marcinsaj/Nixie-Clock-Thermometer-Hygrometer-Arduino-Shield/README.md

# Nixie Clock Thermometer Hygrometer Arduino Shield
----
## [Assembly Instruction can be found here](http://bit.ly/nixieshield-assembly)
----

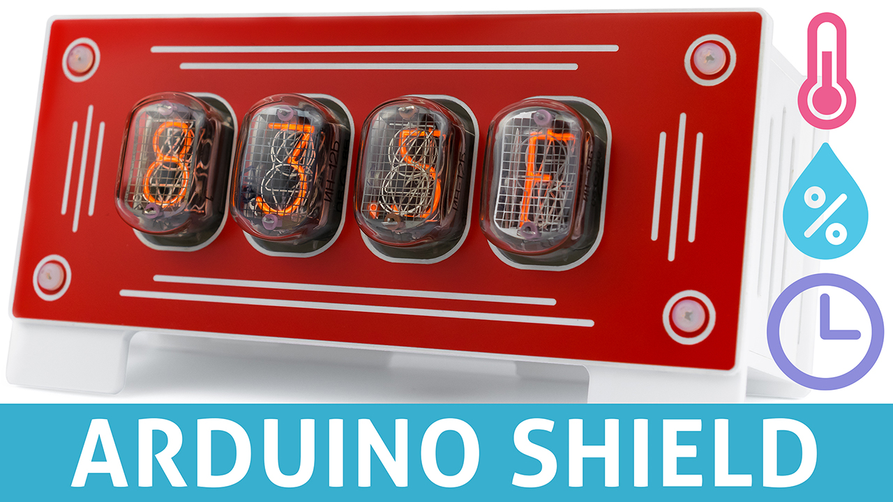
[picture p1: extras/Nixie-Clock-Thermometer-Hygrometer-Arduino-Shield-1.jpg]


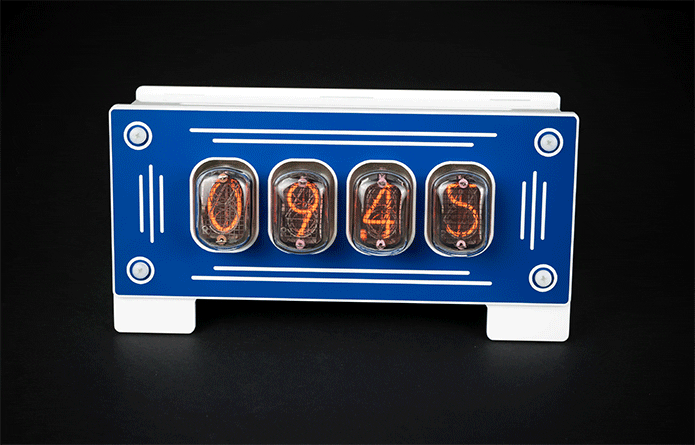
[picture p2: extras/nixie-clock-thermometer-hygrometer-arduino-shield.gif]


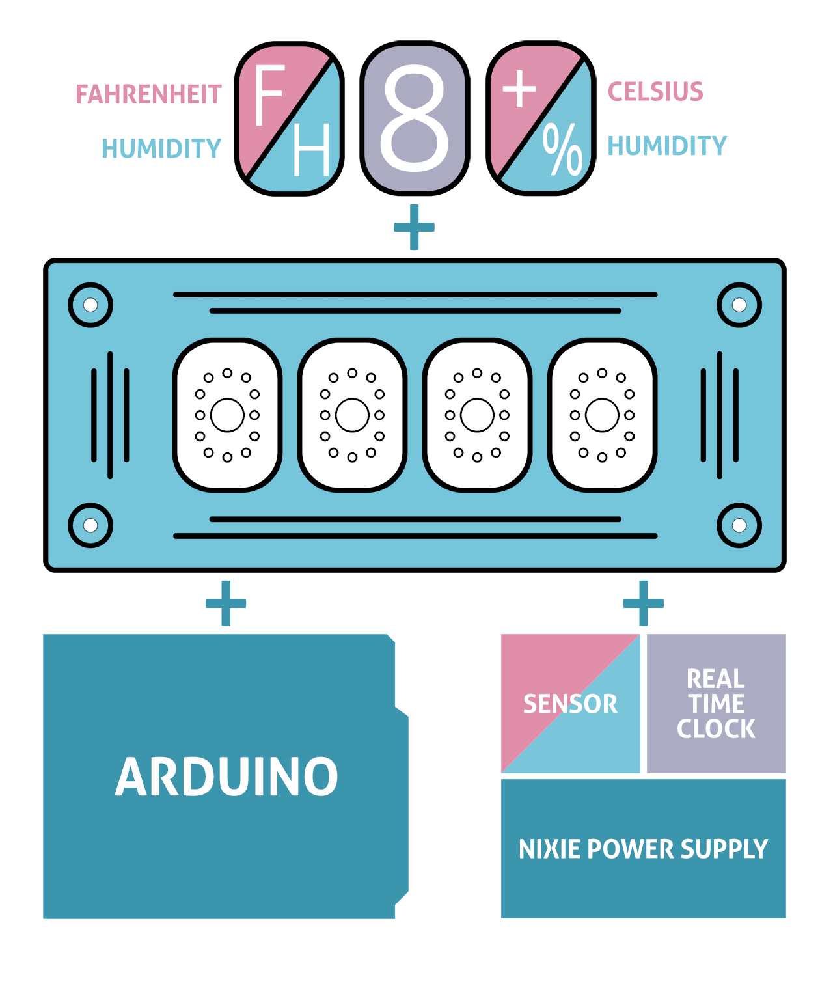
[picture p3: extras/Nixie-Clock-Thermometer-Hygrometer-Arduino-Shield-2.jpg]
