marcinsaj/Nixie-Clock-Thermometer-Hygrometer-Arduino-Shield/assembly-instruction.md

# Assembly Instruction - Nixie Clock Thermometer Hygrometer Arduino Shield
### Components
- Nixie shield mainboard pcb - [schematic](https://github.com/marcinsaj/Nixie-Clock-Thermometer-Hygrometer-Arduino-Shield/blob/master/datasheet/Schematic-Nixie-Clock-Thermometer-Hygrometer-Arduino-Shield.pdf)
- Nixie power supply module (12V => 170V) - [schematic](https://github.com/marcinsaj/Nixie-Clock-Thermometer-Hygrometer-Arduino-Shield/blob/master/datasheet/Schematic-Nixie-Module-Power-Supply.pdf)
- Real time clock module DS3231 - [datasheet](https://github.com/marcinsaj/Nixie-Clock-Thermometer-Hygrometer-Arduino-Shield/blob/master/datasheet/DS3231.pdf)
- Temperature and humidity sensor DHT22/AM2302 - [datasheet](https://github.com/marcinsaj/Nixie-Clock-Thermometer-Hygrometer-Arduino-Shield/blob/master/datasheet/DHT22.pdf)
- Housing
- Other components:
  - Nixie tubes socket pins - 48pcs
  - CON1 (sensor connector)
  - PH1 - pin header 1 x 3F 8.5mm (nixie shield pcb), pin header 1 x 3M 8.5mm (nixie power supply pcb) 
  - PH2 - pin header 1 x 6M 15mm (Arduino)
  - PH3 - pin header 1 x 8M 15mm (Arduino)
  - PH4 - pin header 1 x 4F 8.5mm (nixie shield pcb), pin header 1 x 4M 8.5mm (nixie power supply pcb) 
  - PH5 - pin header 1 x 5M 8.5mm (RTC connector)
  - PH6 - pin header 1 x 8M 15mm (Arduino)
  - PH7 - pin header 1 x 12M 15mm (Arduino)
  - Spacers: 4 x M3-18mm F-F
  - Spacers: 2 x M2.5-18mm M-F
  - Spacers: 2 x M2.5-30mm F-F
  - Spacers: 2 x M2.5-10mm F-F
  - Screws: 8 x M3-8mm
  - Screws: 4 x M2.5-15mm
  - Screws: 4 x M2.5-8mm

----
### Temperature and humidity sensor DHT22/AM2302
----

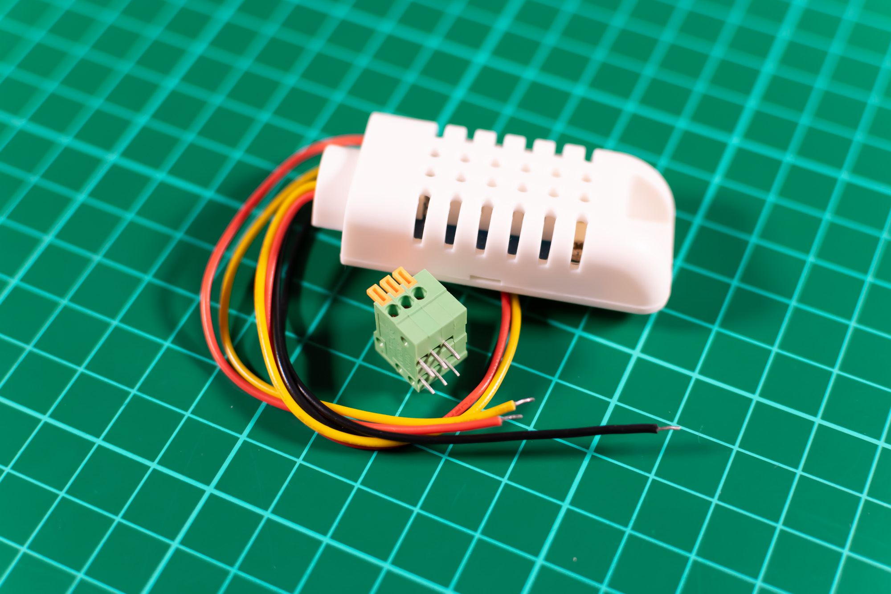
[picture p4: extras/assembly-instruction-images/nixie-shield-assembly-instruction_55.jpg]


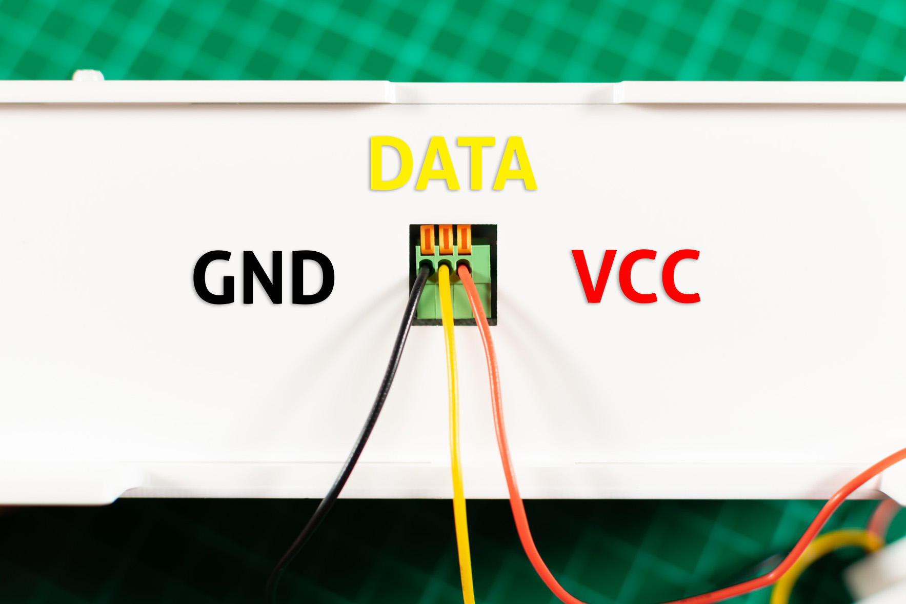
[picture p5: extras/assembly-instruction-images/nixie-shield-assembly-instruction_53.jpg]


----
### Assembly Instruction
----
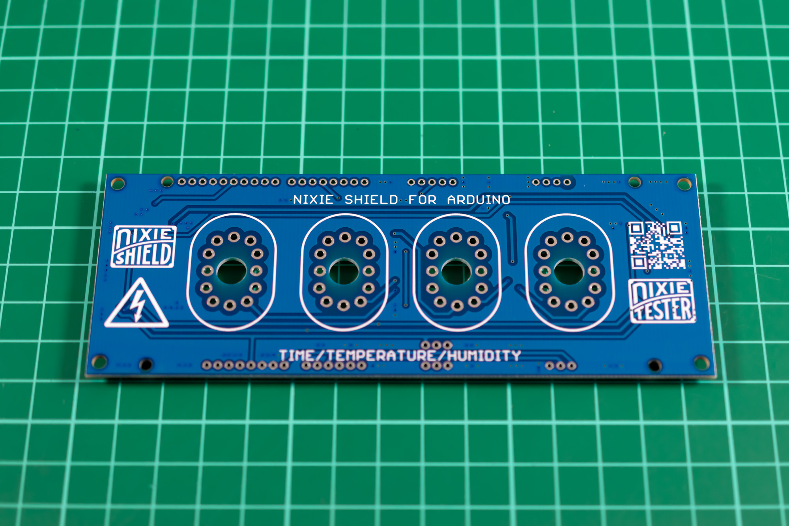
[picture p6: extras/assembly-instruction-images/nixie-shield-assembly-instruction_01.jpg]


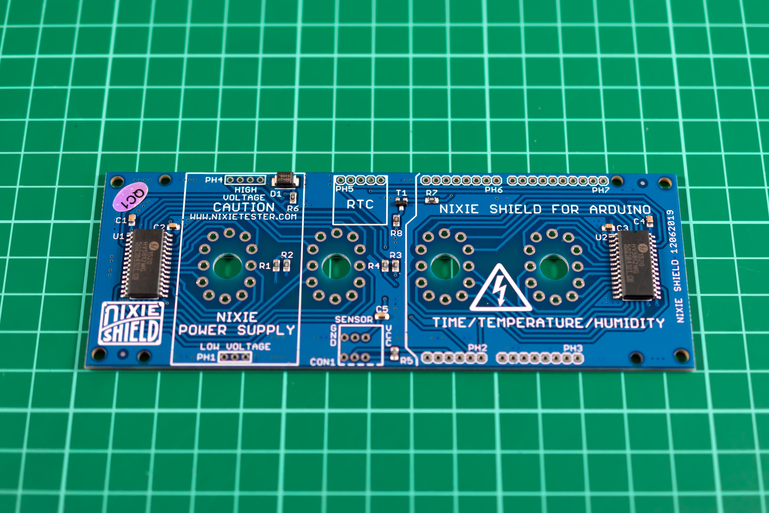
[picture p7: extras/assembly-instruction-images/nixie-shield-assembly-instruction_02.jpg]


----
### PH1 - pin header 1 x 3F 8.5mm

### PH4 - pin header 1 x 4F 8.5mm
----

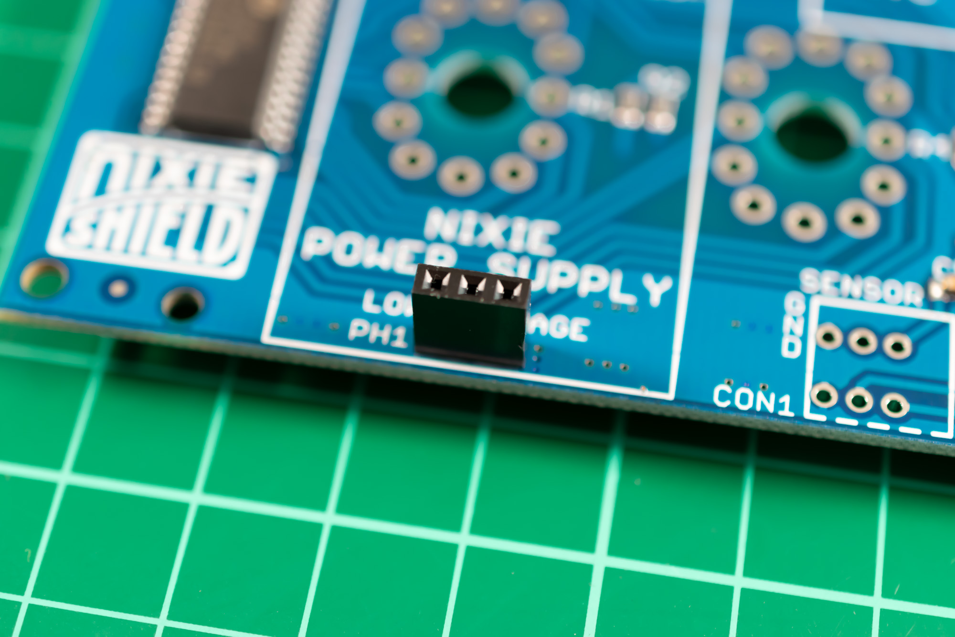
[picture p8: extras/assembly-instruction-images/nixie-shield-assembly-instruction_03.jpg]


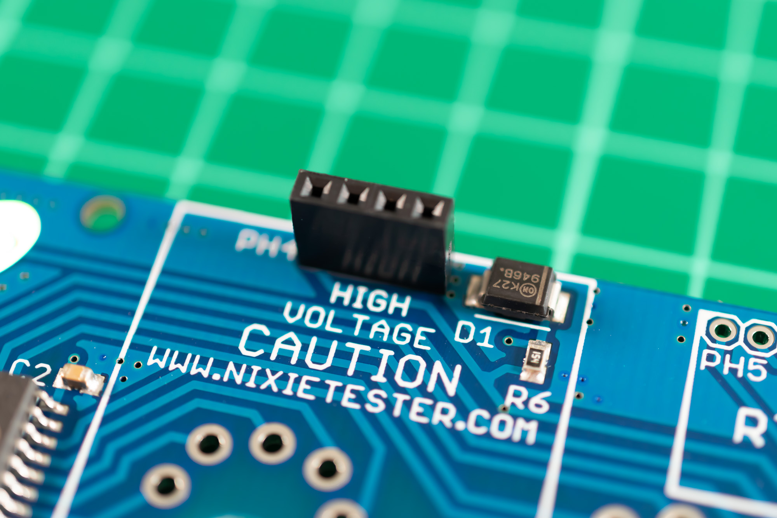
[picture p9: extras/assembly-instruction-images/nixie-shield-assembly-instruction_04.jpg]


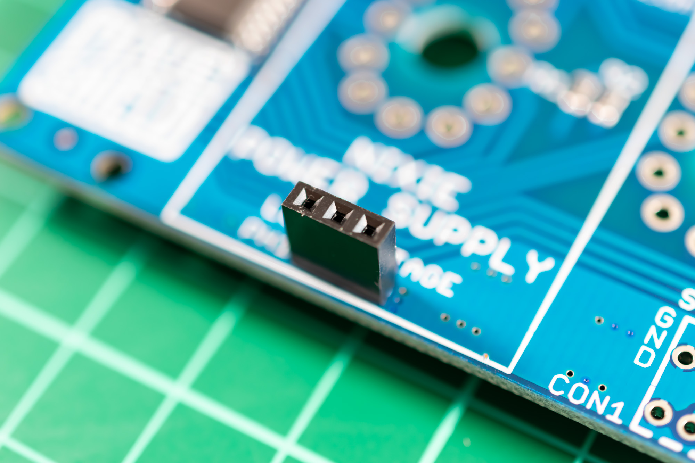
[picture p10: extras/assembly-instruction-images/nixie-shield-assembly-instruction_05.jpg]


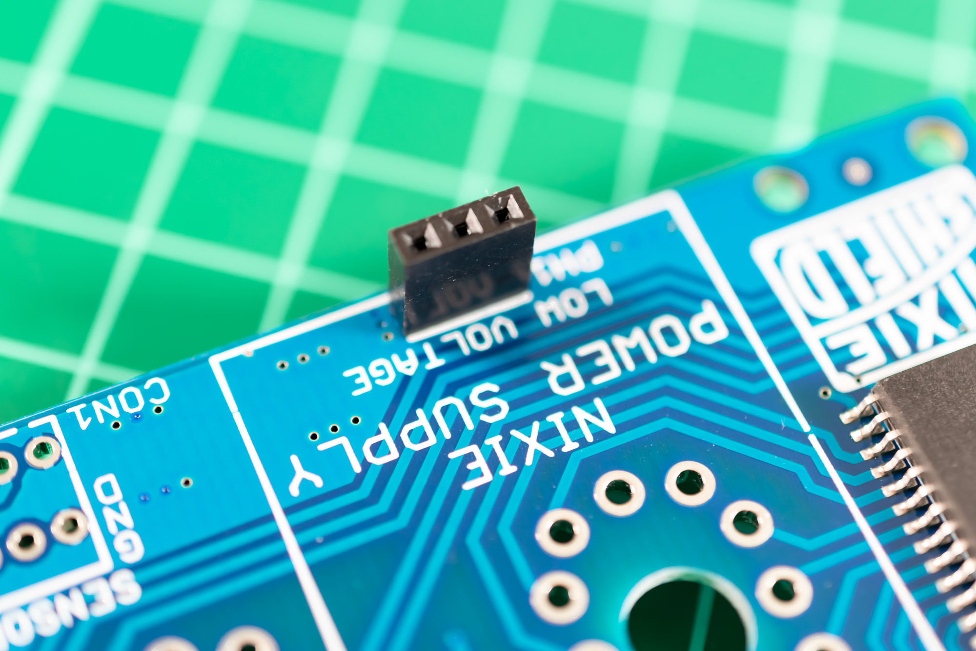
[picture p11: extras/assembly-instruction-images/nixie-shield-assembly-instruction_06.jpg]


----
### PH5 - pin header 1 x 5M 8.5mm (RTC)
----

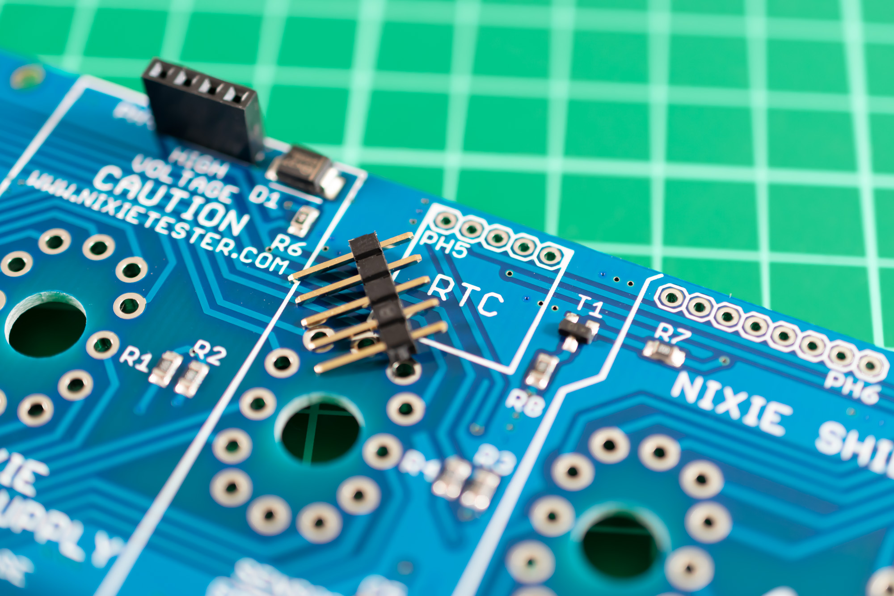
[picture p12: extras/assembly-instruction-images/nixie-shield-assembly-instruction_07.jpg]


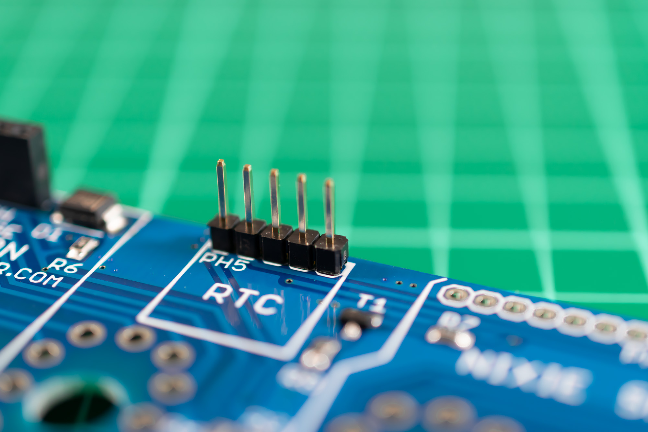
[picture p13: extras/assembly-instruction-images/nixie-shield-assembly-instruction_08.jpg]


----
### PH2 - pin header 1 x 6M 15mm (Arduino)

### PH3 - pin header 1 x 8M 15mm (Arduino)

### PH6 - pin header 1 x 8M 15mm (Arduino)

### PH7 - pin header 1 x 12M 15mm (Arduino)
----

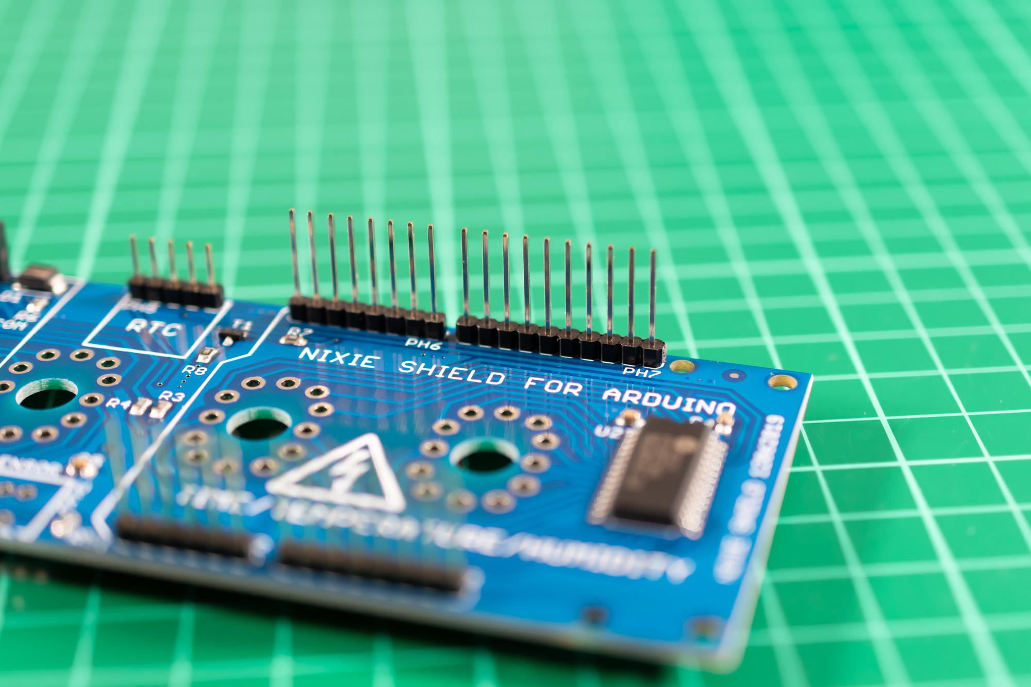
[picture p14: extras/assembly-instruction-images/nixie-shield-assembly-instruction_09.jpg]


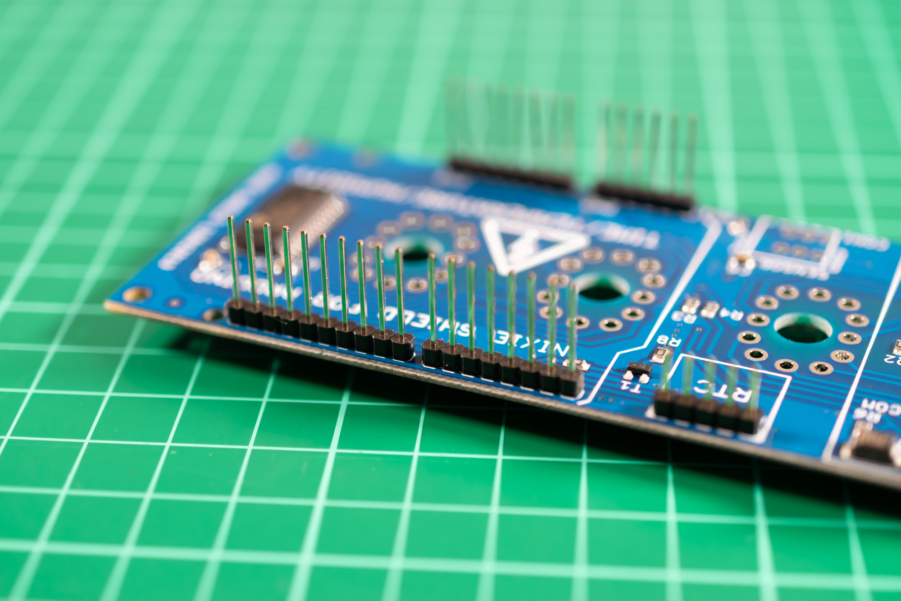
[picture p15: extras/assembly-instruction-images/nixie-shield-assembly-instruction_10.jpg]


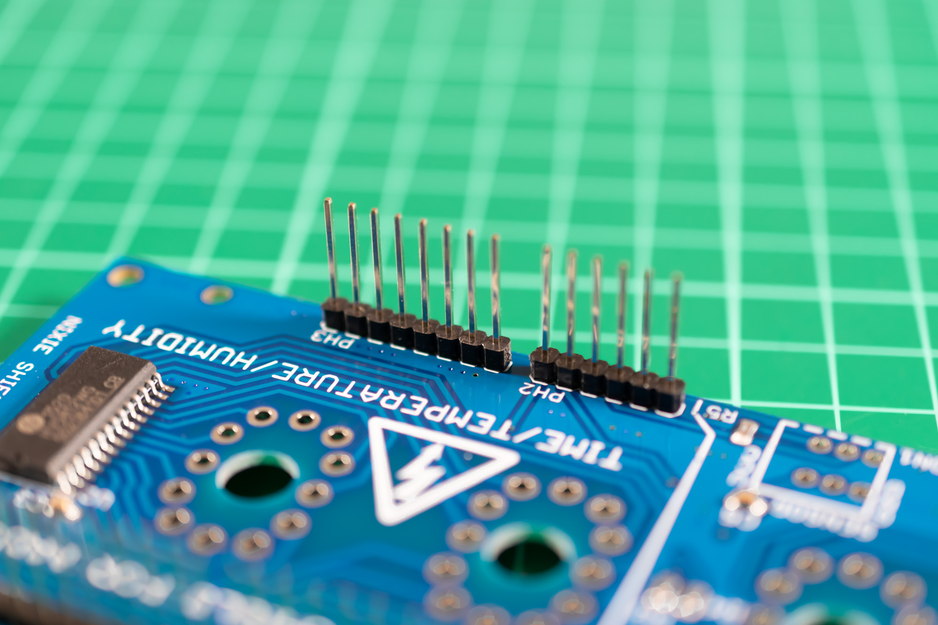
[picture p16: extras/assembly-instruction-images/nixie-shield-assembly-instruction_11.jpg]


----
### CON1 (sensor connector)
----

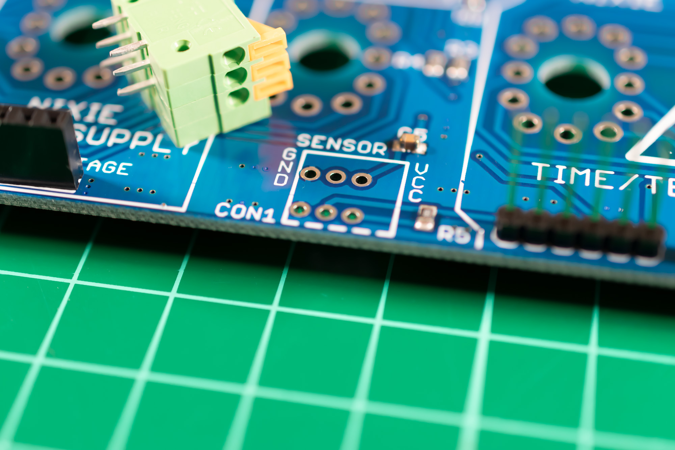
[picture p17: extras/assembly-instruction-images/nixie-shield-assembly-instruction_12.jpg]


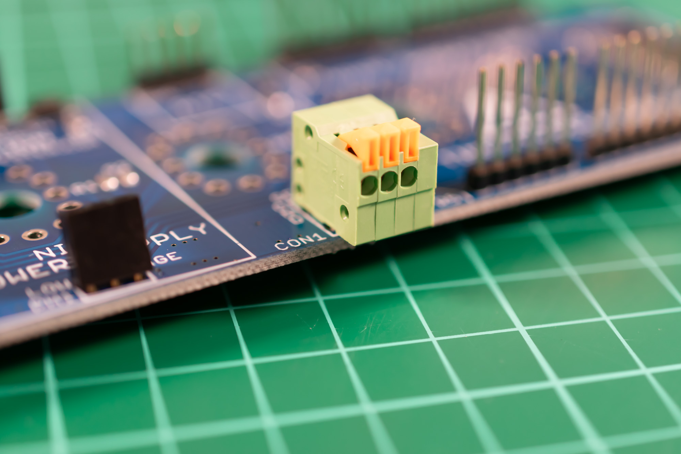
[picture p18: extras/assembly-instruction-images/nixie-shield-assembly-instruction_13.jpg]


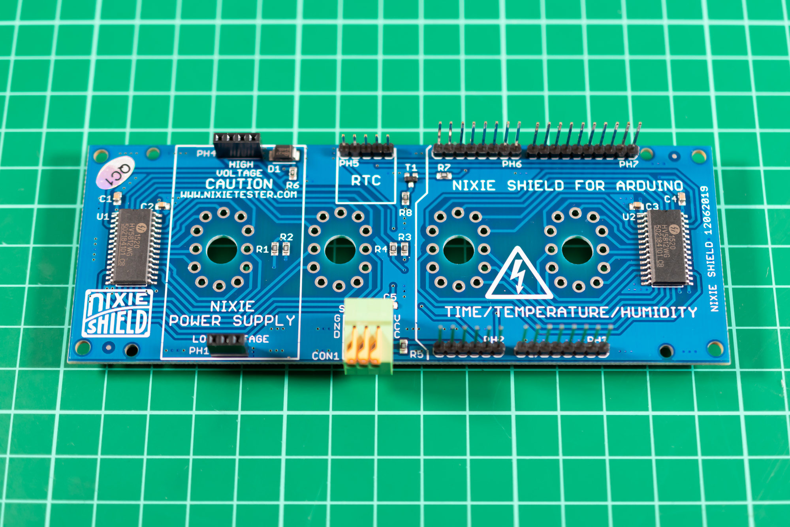
[picture p19: extras/assembly-instruction-images/nixie-shield-assembly-instruction_14.jpg]


----
### Nixie tubes socket pins assembly
----

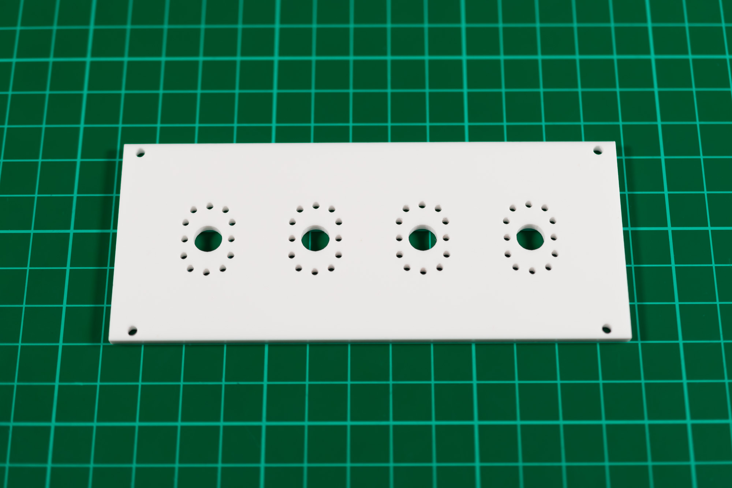
[picture p20: extras/assembly-instruction-images/nixie-shield-assembly-instruction_15.jpg]


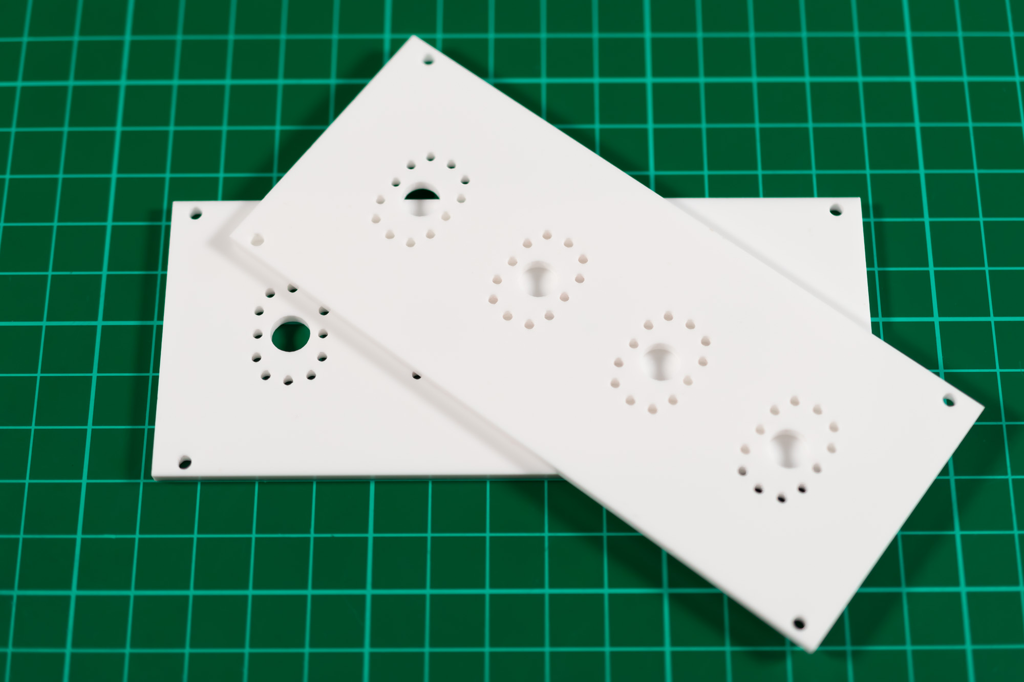
[picture p21: extras/assembly-instruction-images/nixie-shield-assembly-instruction_16.jpg]


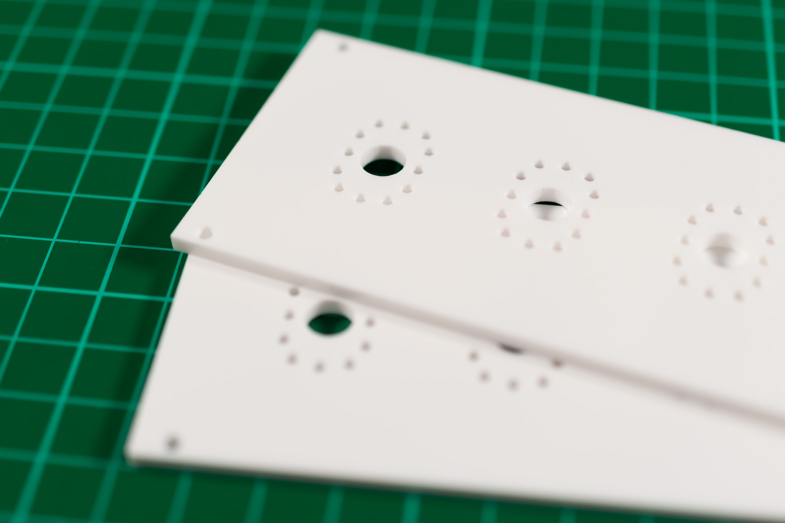
[picture p22: extras/assembly-instruction-images/nixie-shield-assembly-instruction_17.jpg]


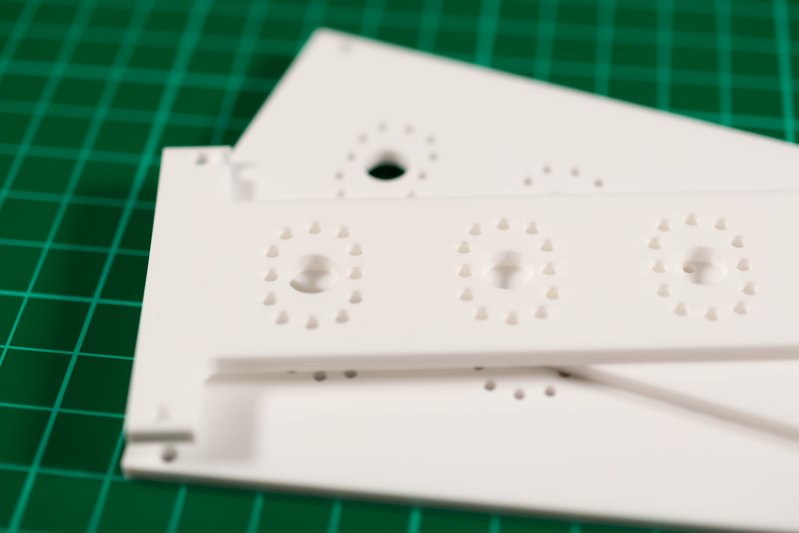
[picture p23: extras/assembly-instruction-images/nixie-shield-assembly-instruction_18.jpg]


----
### The notch marked in red should be on the top right
----

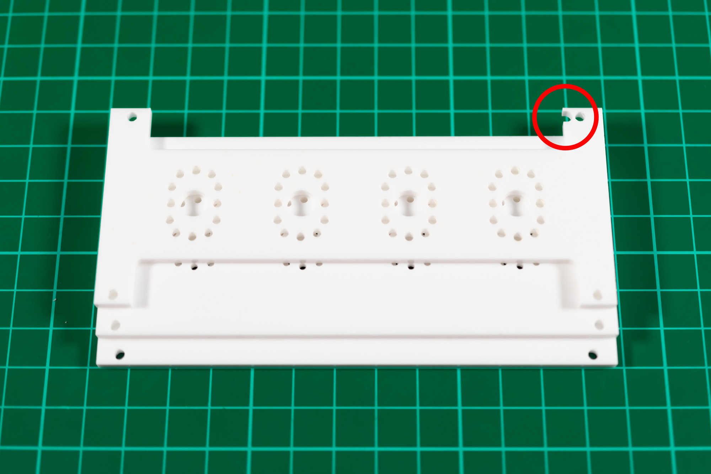
[picture p24: extras/assembly-instruction-images/nixie-shield-assembly-instruction_19.jpg]


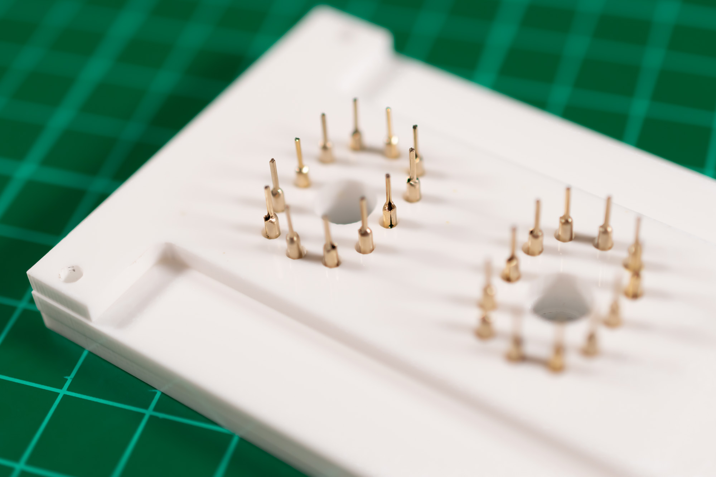
[picture p25: extras/assembly-instruction-images/nixie-shield-assembly-instruction_20.jpg]


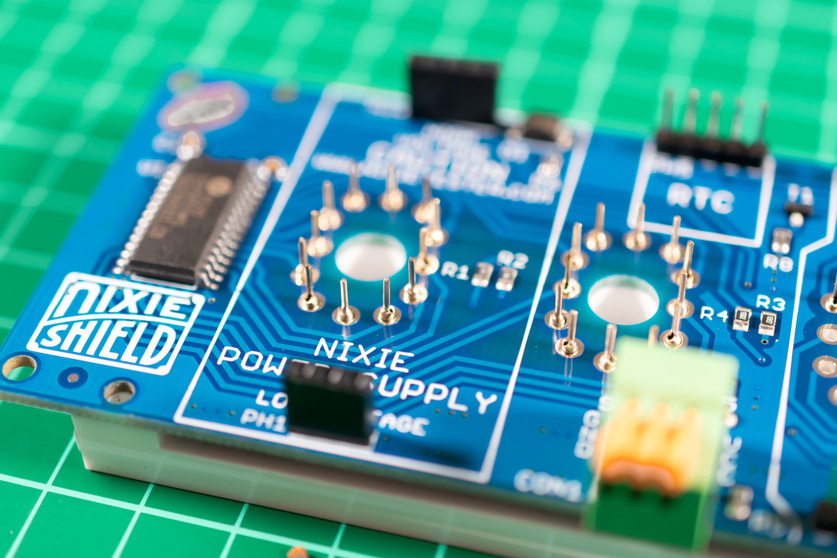
[picture p26: extras/assembly-instruction-images/nixie-shield-assembly-instruction_21.jpg]


----
### Housing assembly
----

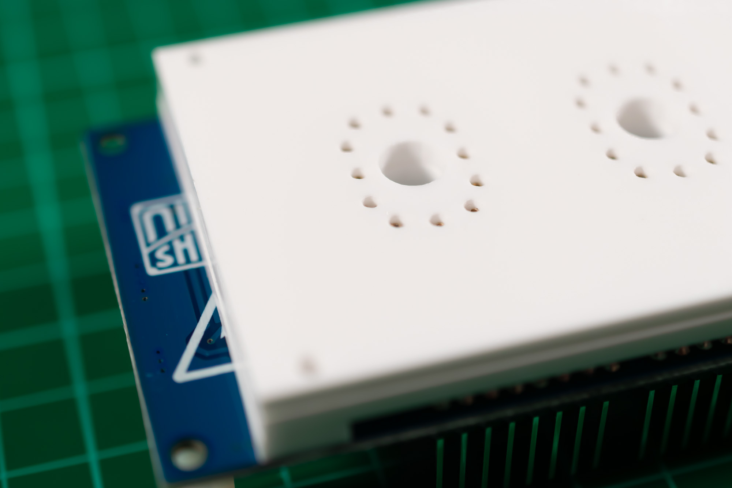
[picture p27: extras/assembly-instruction-images/nixie-shield-assembly-instruction_22.jpg]


----
### Screws: 4 x M2.5-15mm
----

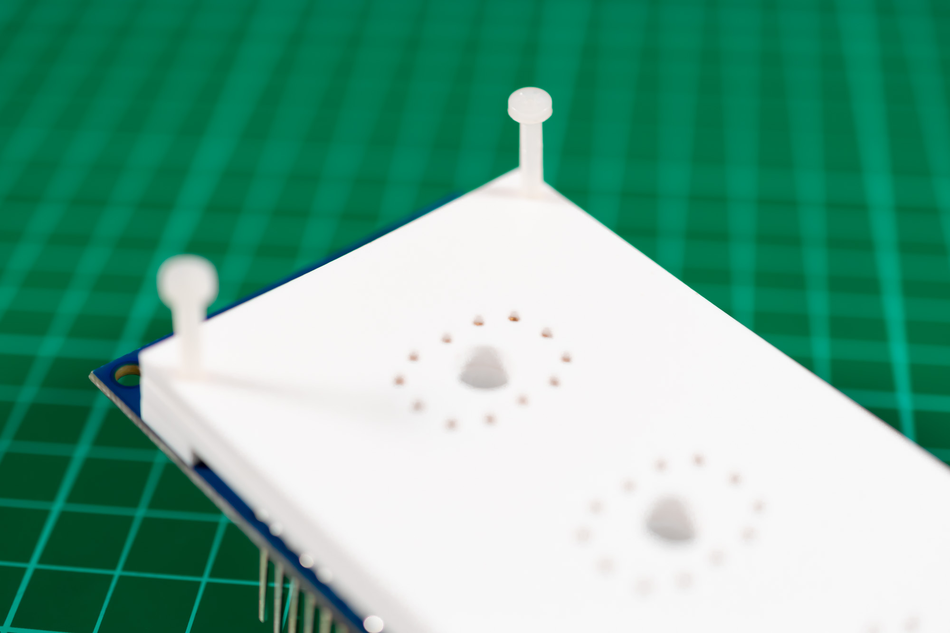
[picture p28: extras/assembly-instruction-images/nixie-shield-assembly-instruction_23.jpg]


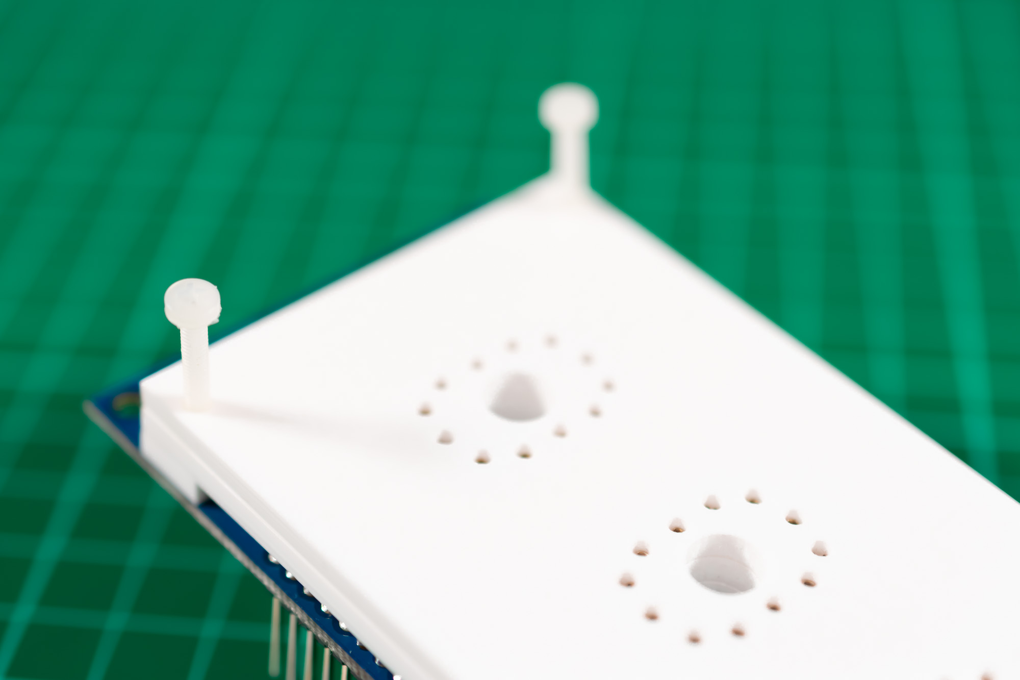
[picture p29: extras/assembly-instruction-images/nixie-shield-assembly-instruction_24.jpg]


----
### Spacers: 2 x M2.5-18mm M-F
----

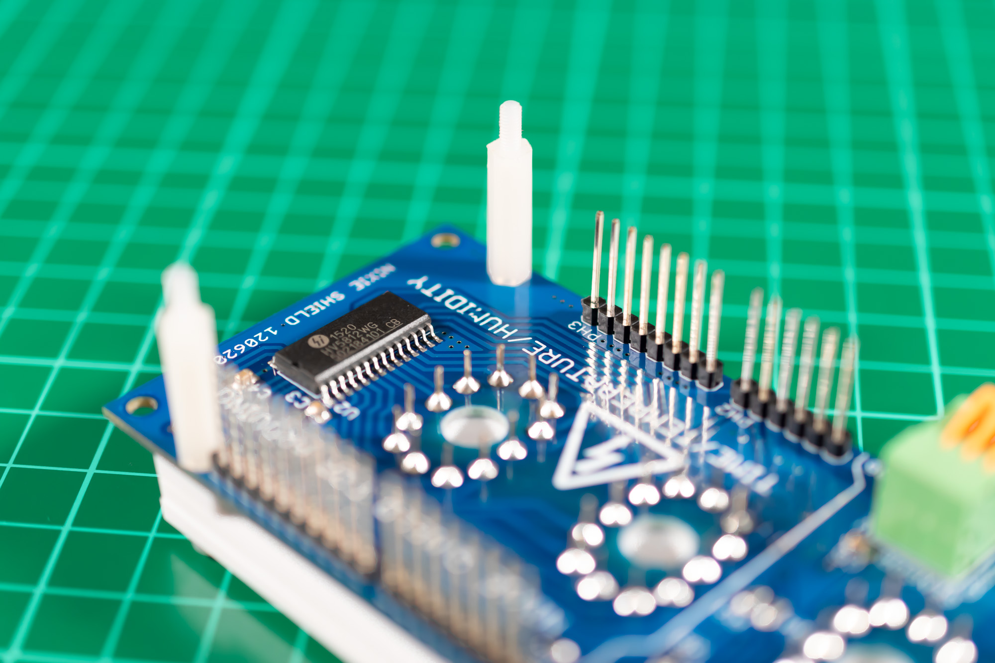
[picture p30: extras/assembly-instruction-images/nixie-shield-assembly-instruction_25.jpg]


----
### Spacers: 2 x M2.5-30mm F-F
----

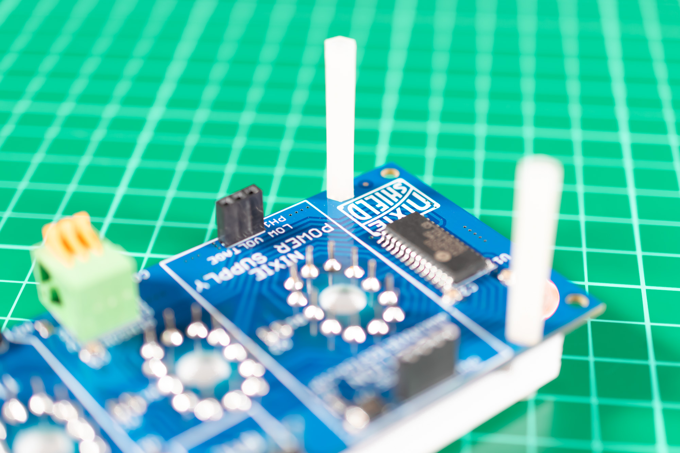
[picture p31: extras/assembly-instruction-images/nixie-shield-assembly-instruction_26.jpg]


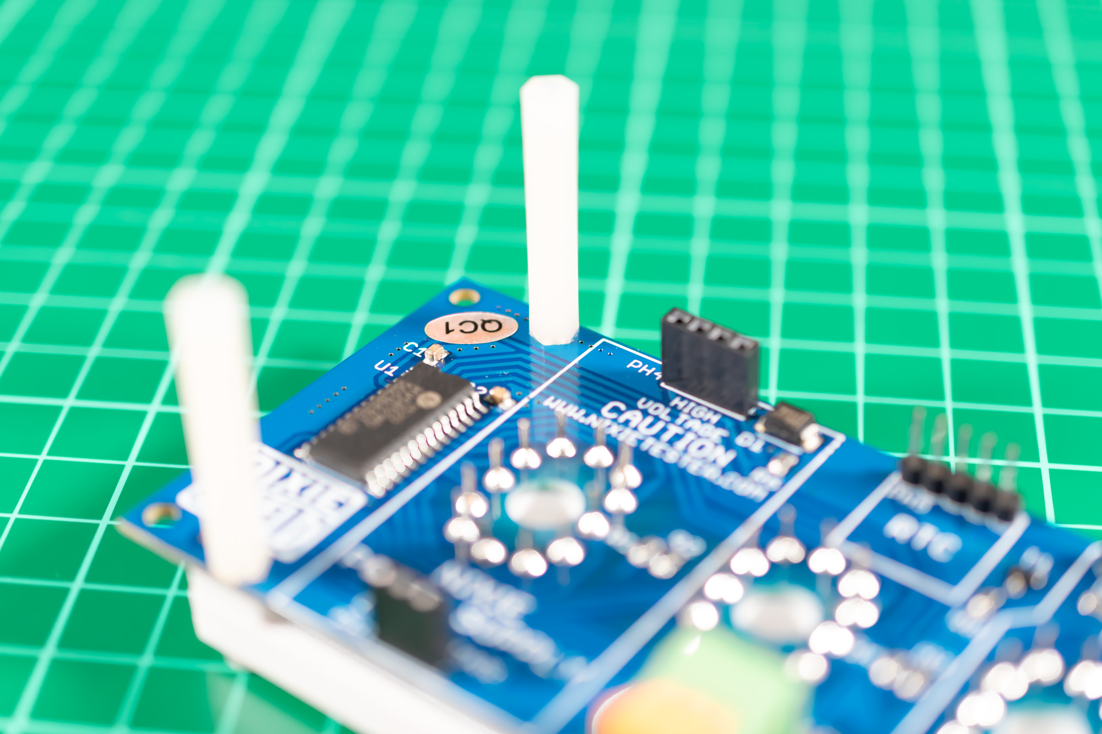
[picture p32: extras/assembly-instruction-images/nixie-shield-assembly-instruction_27.jpg]


----
### Screws: 4 x M3-8mm
----

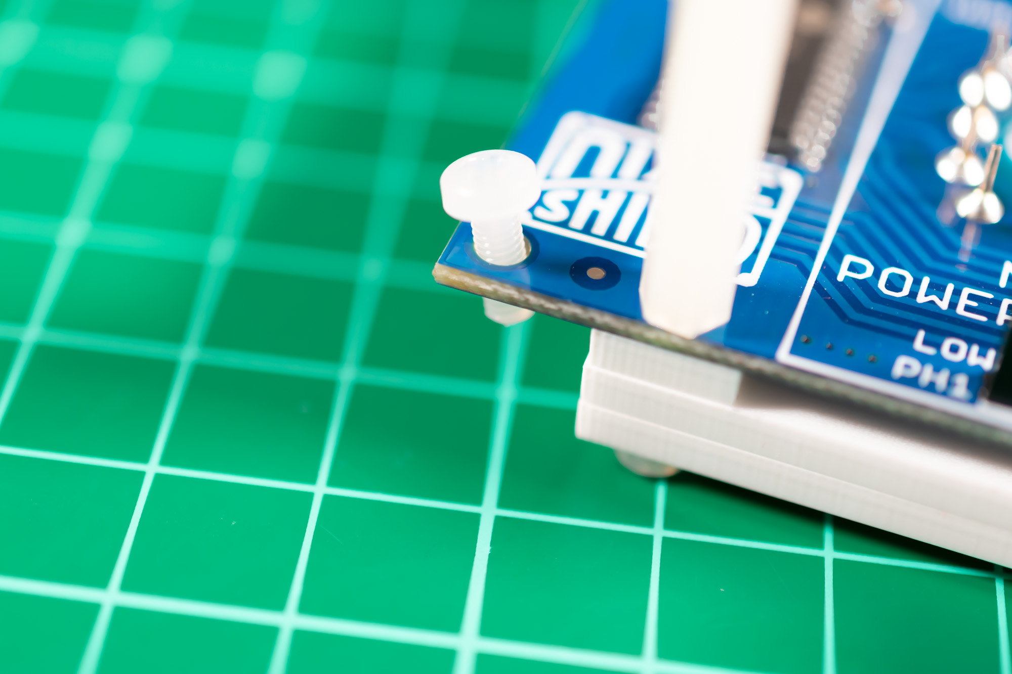
[picture p33: extras/assembly-instruction-images/nixie-shield-assembly-instruction_28.jpg]


----
### Spacers: 4 x M3-18mm F-F
----

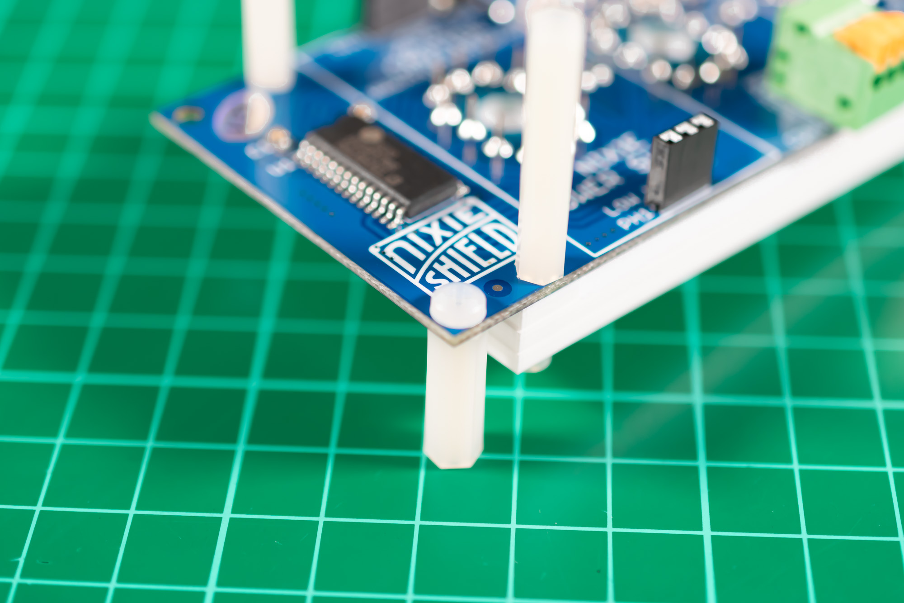
[picture p34: extras/assembly-instruction-images/nixie-shield-assembly-instruction_29.jpg]


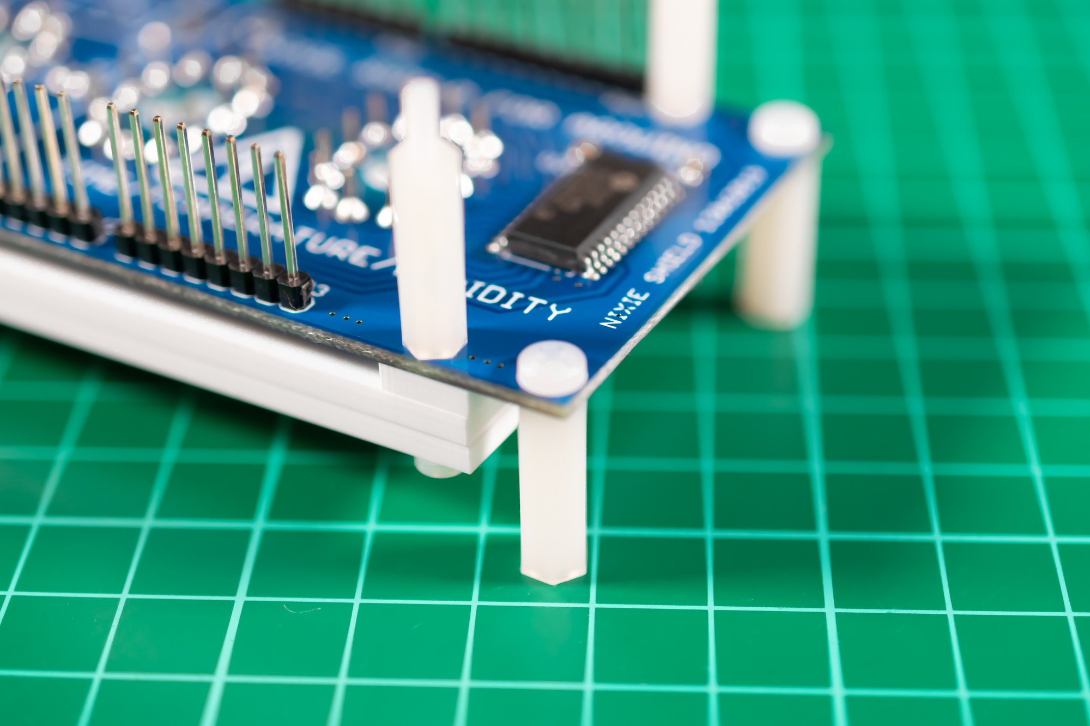
[picture p35: extras/assembly-instruction-images/nixie-shield-assembly-instruction_30.jpg]


----
### Front panel
----

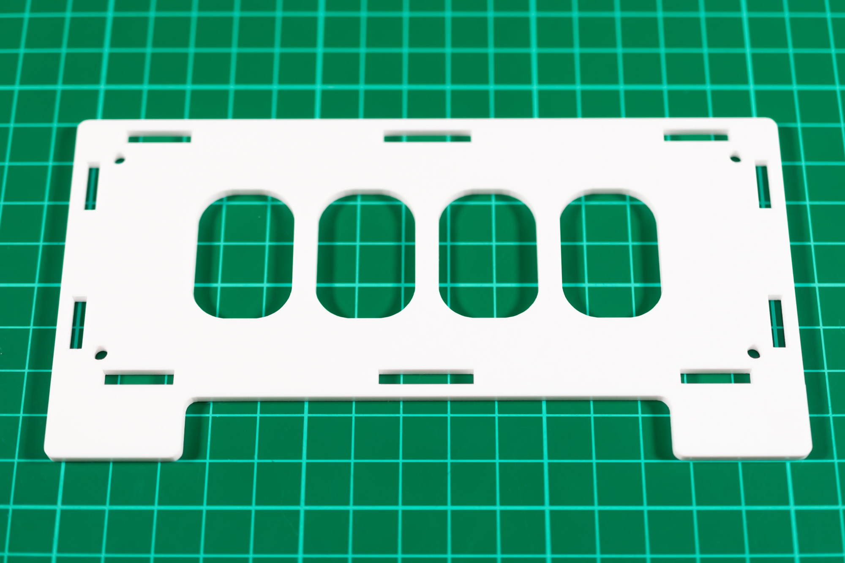
[picture p36: extras/assembly-instruction-images/nixie-shield-assembly-instruction_31.jpg]


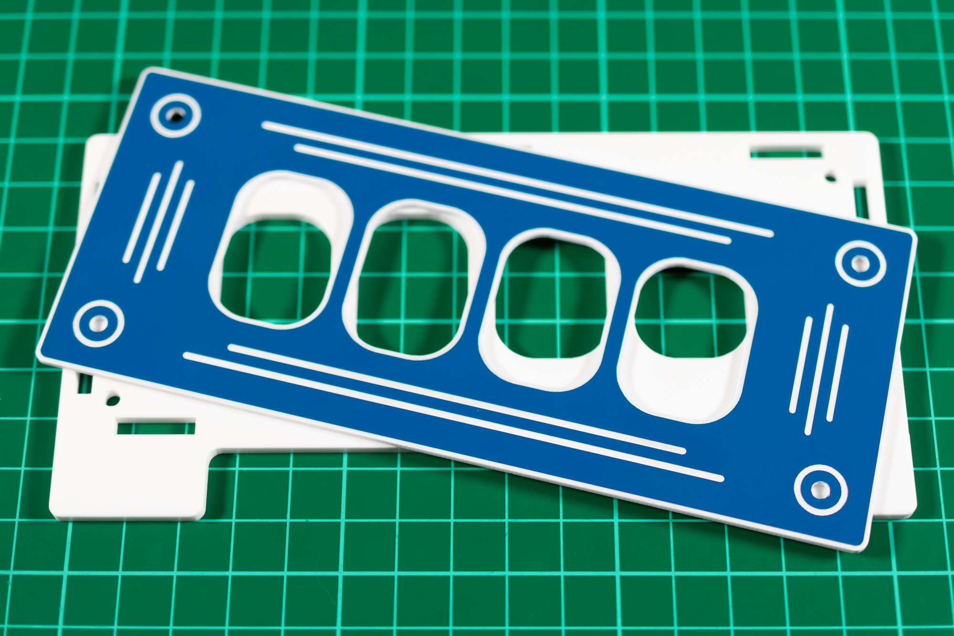
[picture p37: extras/assembly-instruction-images/nixie-shield-assembly-instruction_32.jpg]


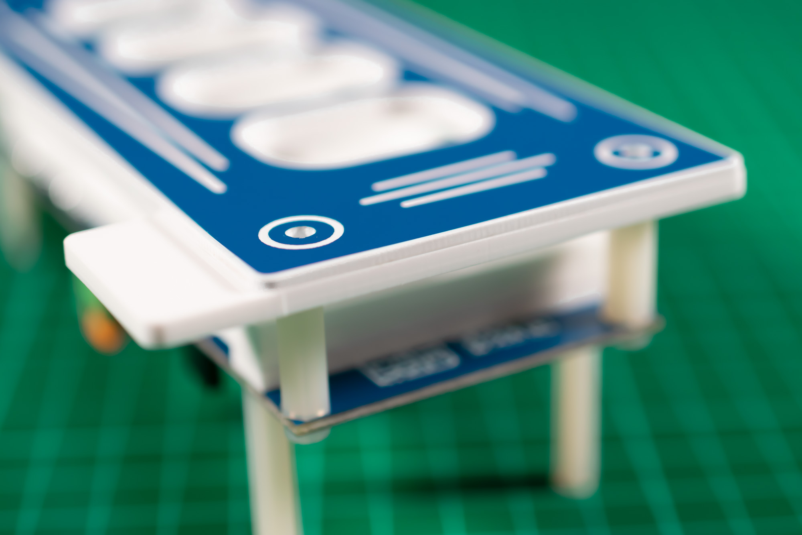
[picture p38: extras/assembly-instruction-images/nixie-shield-assembly-instruction_33.jpg]


----
### Screws: 4 x M3-8mm
----

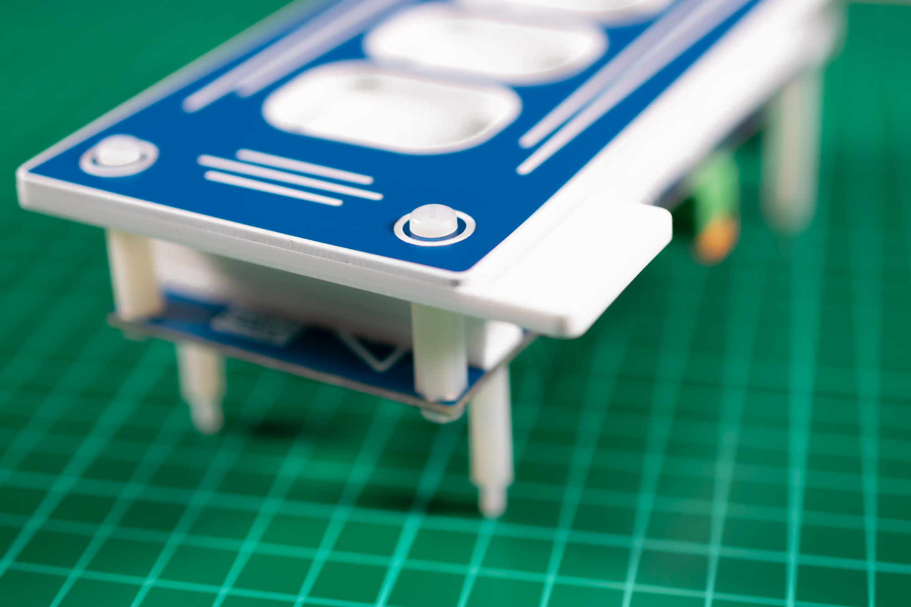
[picture p39: extras/assembly-instruction-images/nixie-shield-assembly-instruction_34.jpg]


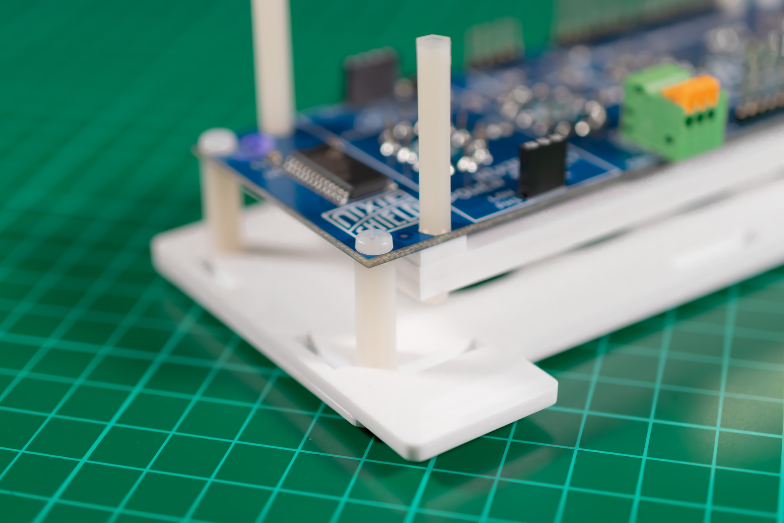
[picture p40: extras/assembly-instruction-images/nixie-shield-assembly-instruction_35.jpg]


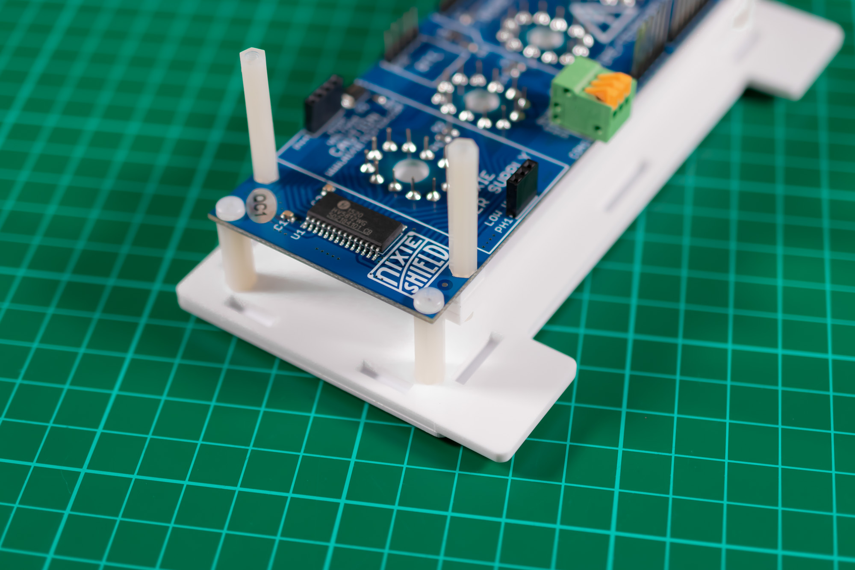
[picture p41: extras/assembly-instruction-images/nixie-shield-assembly-instruction_36.jpg]


----
### Arduino mounting
----

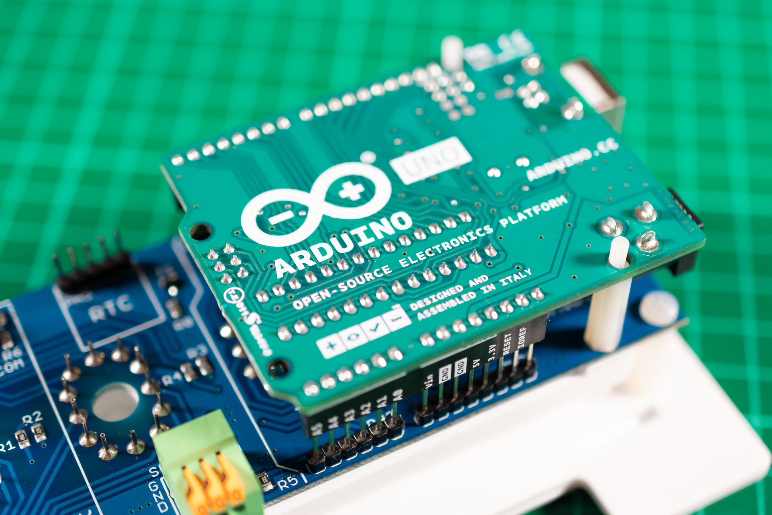
[picture p42: extras/assembly-instruction-images/nixie-shield-assembly-instruction_40.jpg]


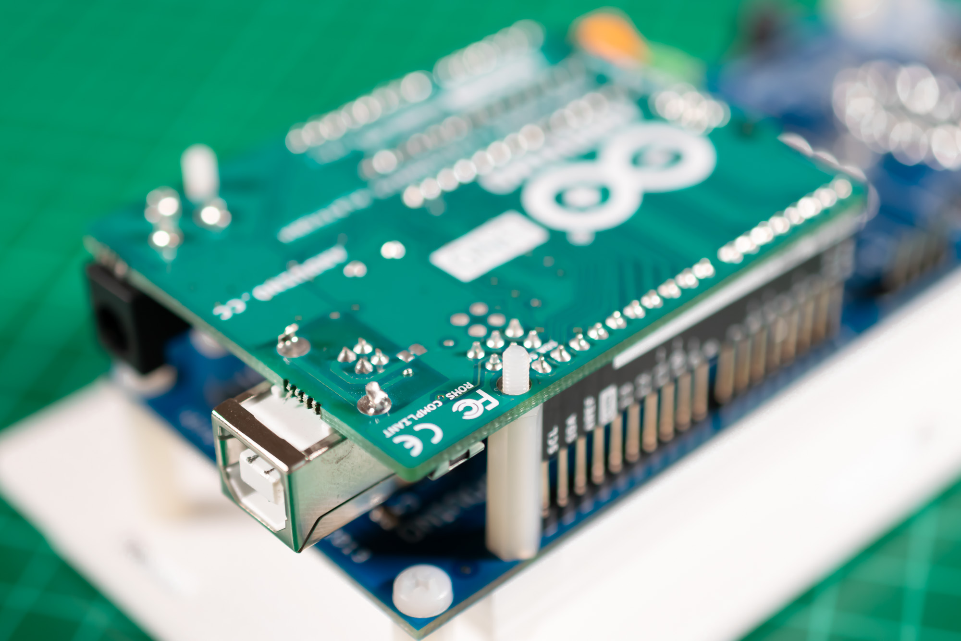
[picture p43: extras/assembly-instruction-images/nixie-shield-assembly-instruction_41.jpg]


----
### Spacers: 2 x M2.5-10mm F-F
----

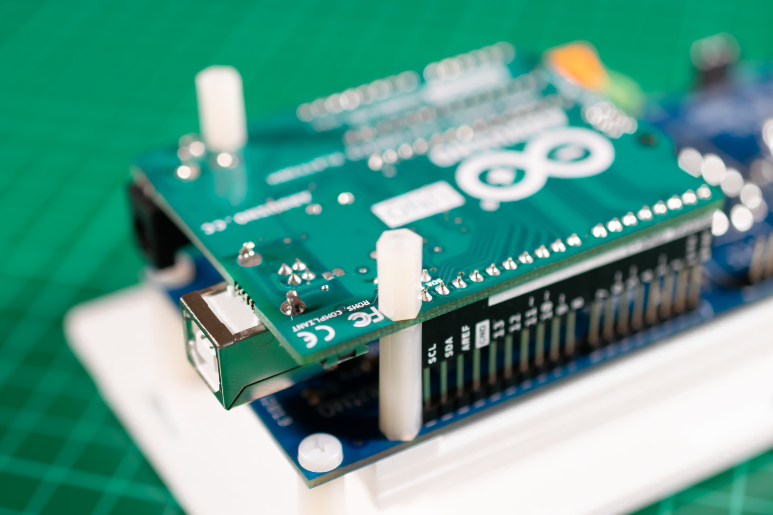
[picture p44: extras/assembly-instruction-images/nixie-shield-assembly-instruction_42.jpg]


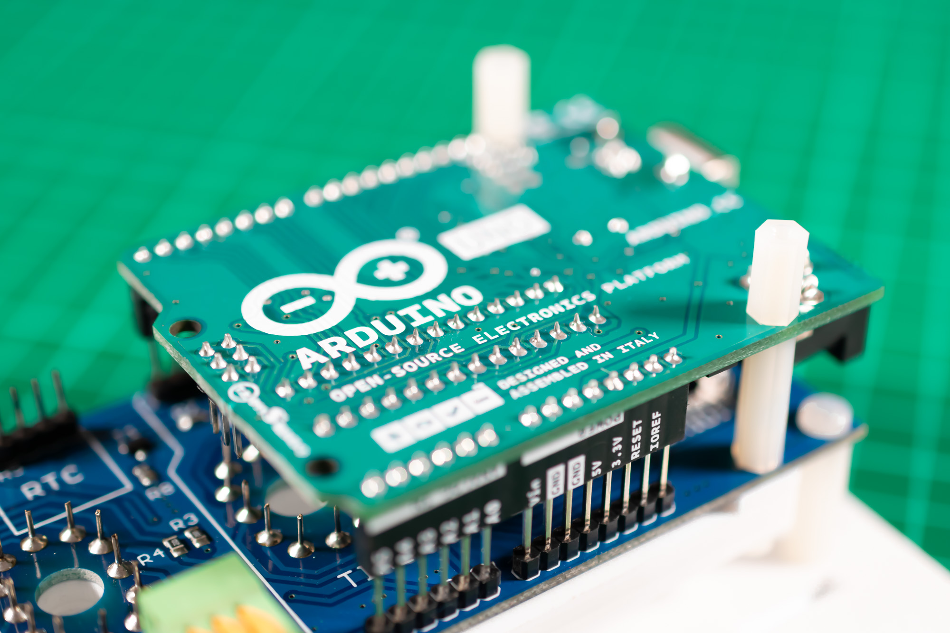
[picture p45: extras/assembly-instruction-images/nixie-shield-assembly-instruction_43.jpg]


----
### RTC module
----

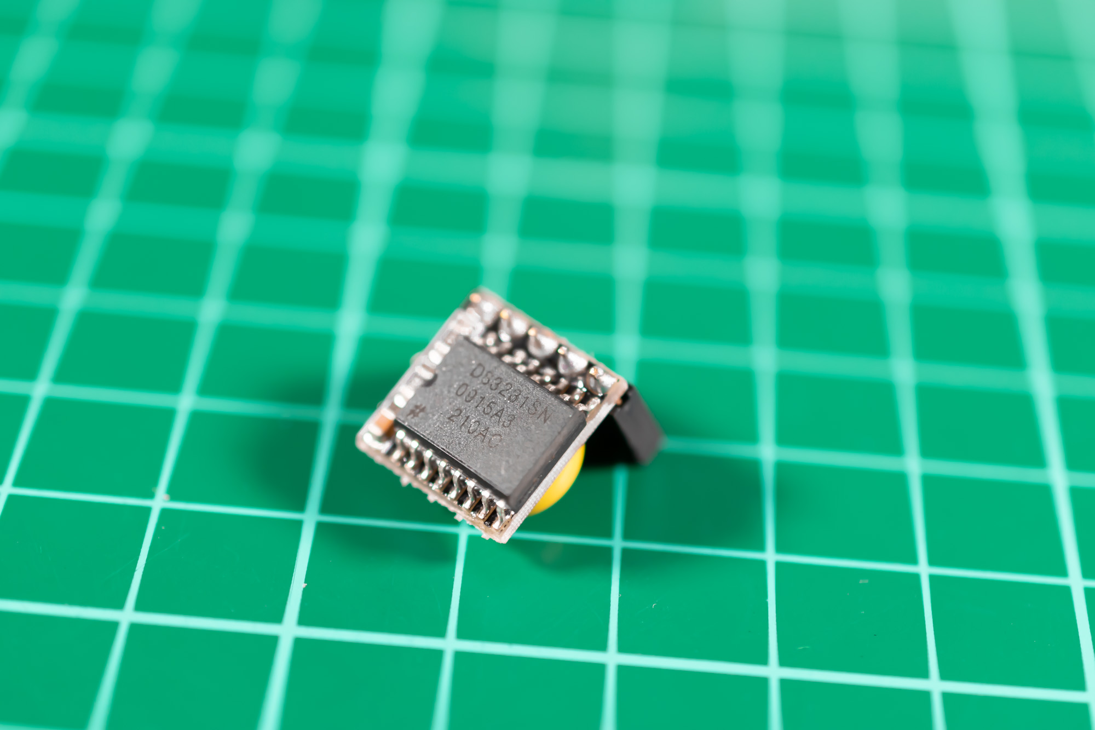
[picture p46: extras/assembly-instruction-images/nixie-shield-assembly-instruction_44.jpg]


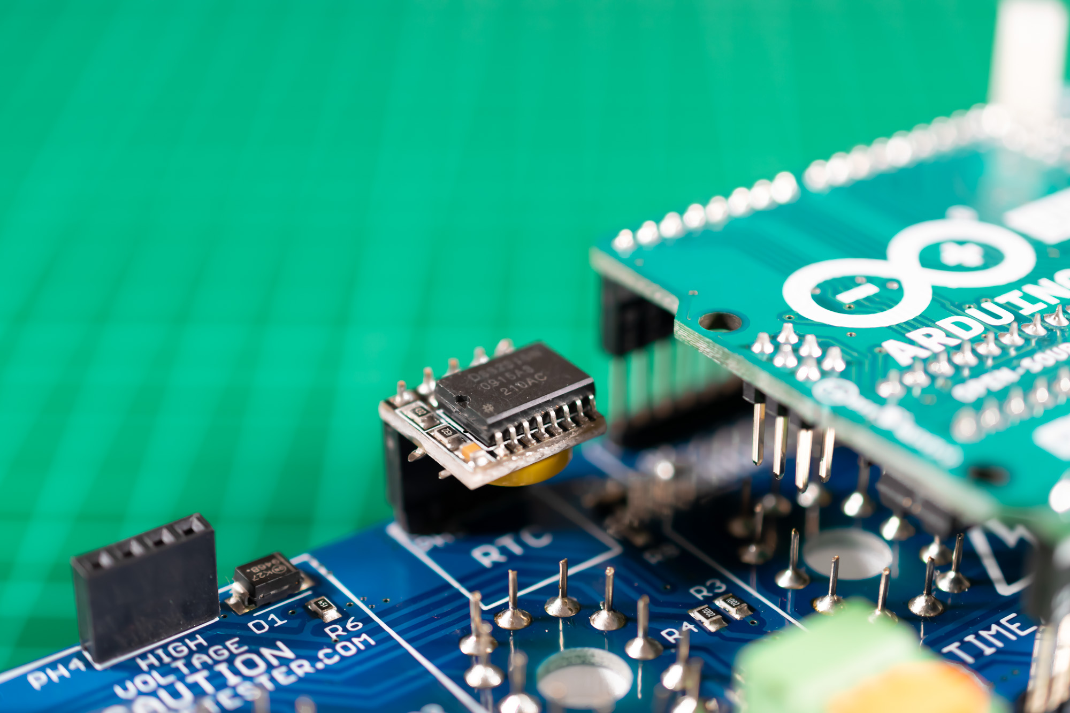
[picture p47: extras/assembly-instruction-images/nixie-shield-assembly-instruction_45.jpg]


----
### Nixie power supply module

### Pin header 1 x 3M 8.5mm

### Pin header 1 x 4M 8.5mm 
----

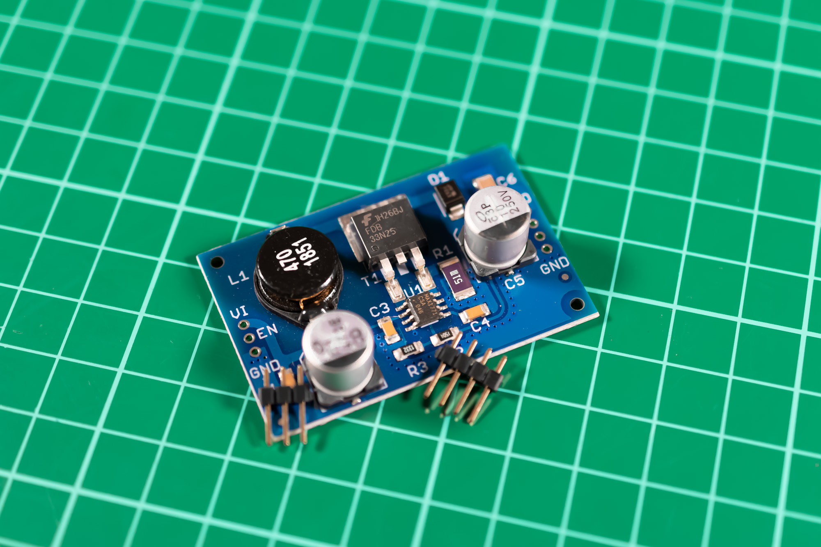
[picture p48: extras/assembly-instruction-images/nixie-shield-assembly-instruction_37.jpg]


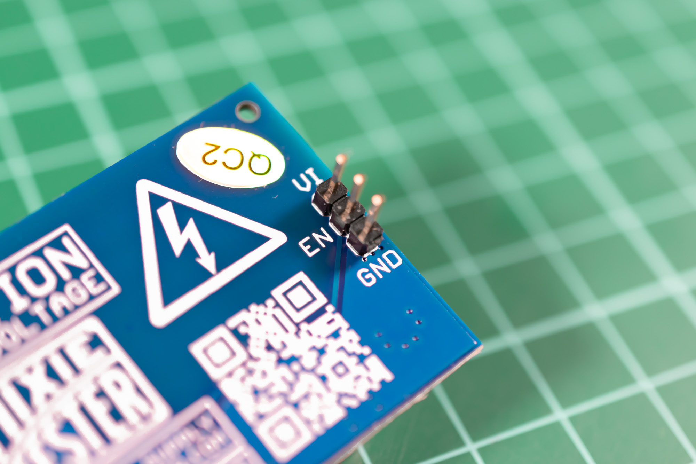
[picture p49: extras/assembly-instruction-images/nixie-shield-assembly-instruction_38.jpg]


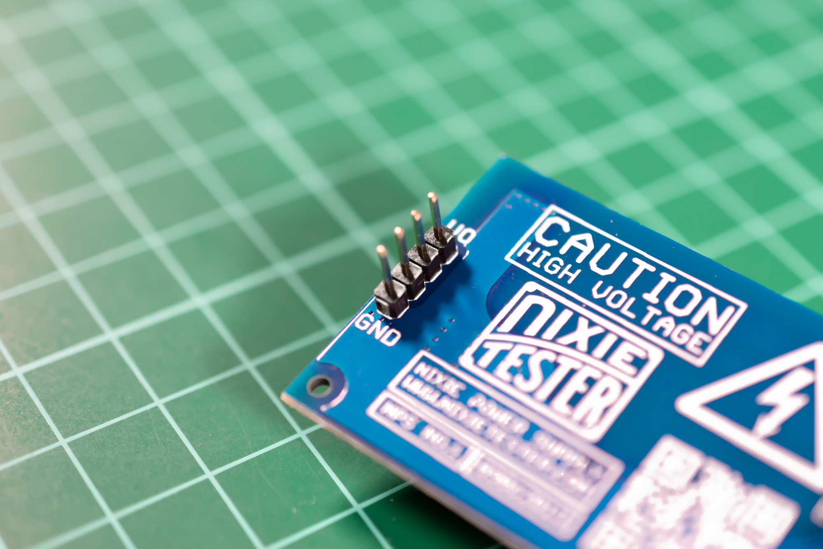
[picture p50: extras/assembly-instruction-images/nixie-shield-assembly-instruction_39.jpg]


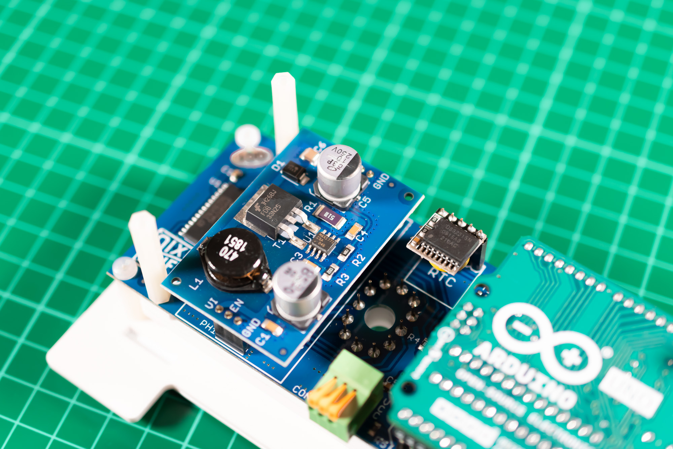
[picture p51: extras/assembly-instruction-images/nixie-shield-assembly-instruction_46.jpg]


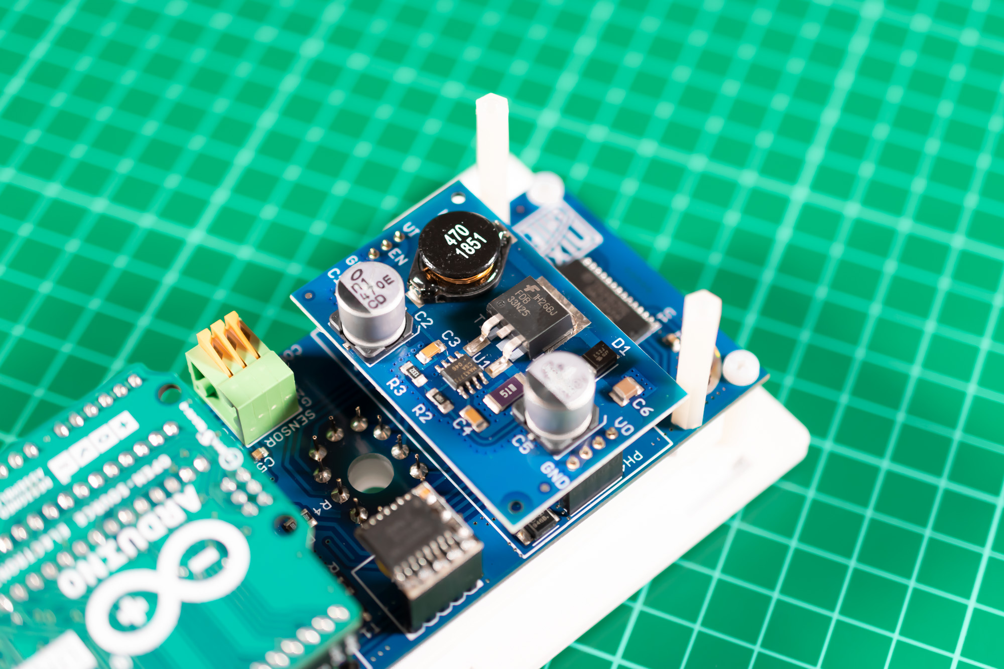
[picture p52: extras/assembly-instruction-images/nixie-shield-assembly-instruction_47.jpg]


----
### Side panels
----

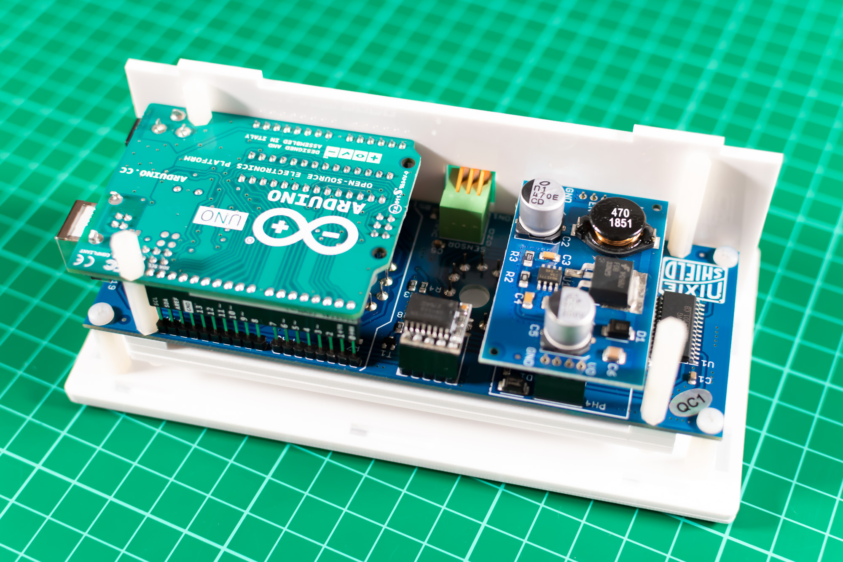
[picture p53: extras/assembly-instruction-images/nixie-shield-assembly-instruction_48.jpg]


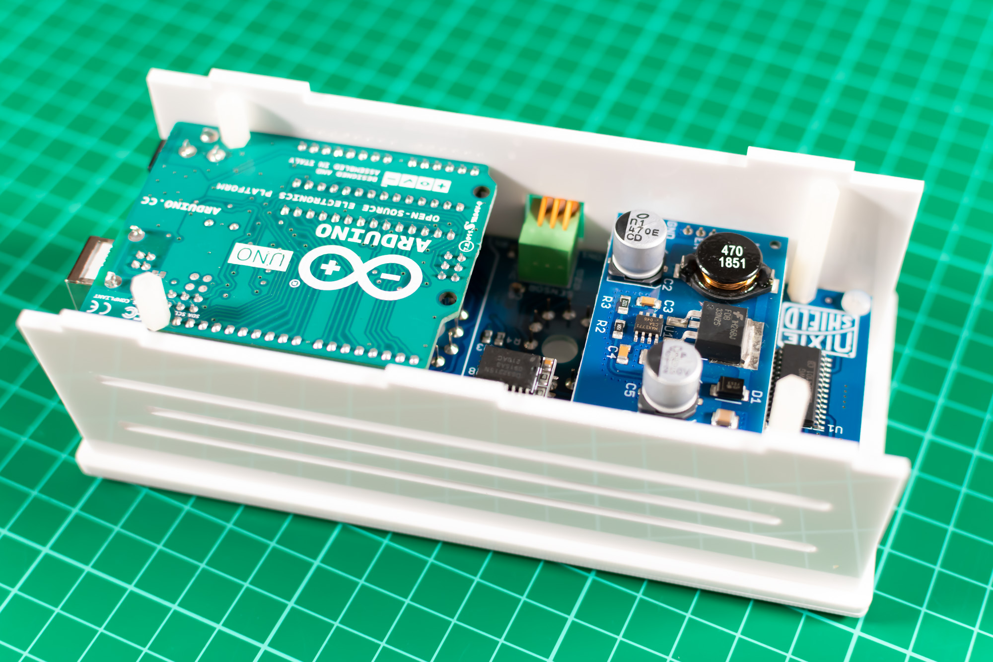
[picture p54: extras/assembly-instruction-images/nixie-shield-assembly-instruction_49.jpg]


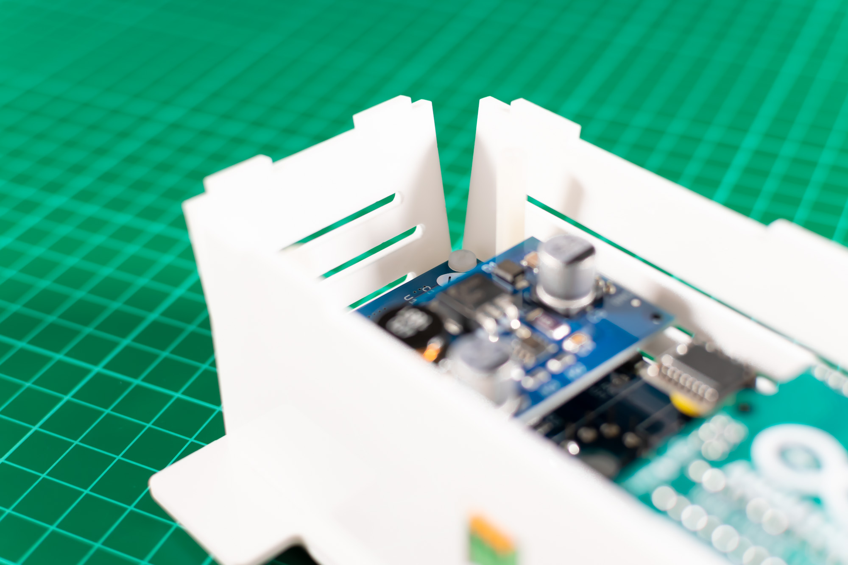
[picture p55: extras/assembly-instruction-images/nixie-shield-assembly-instruction_50.jpg]


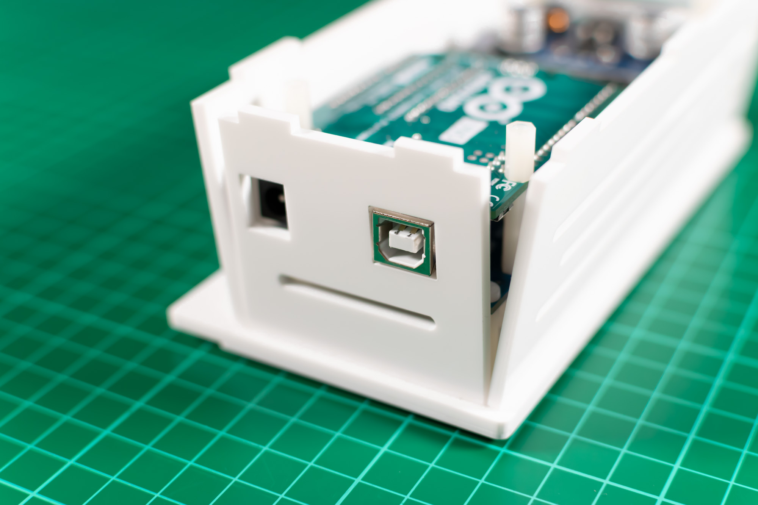
[picture p56: extras/assembly-instruction-images/nixie-shield-assembly-instruction_51.jpg]


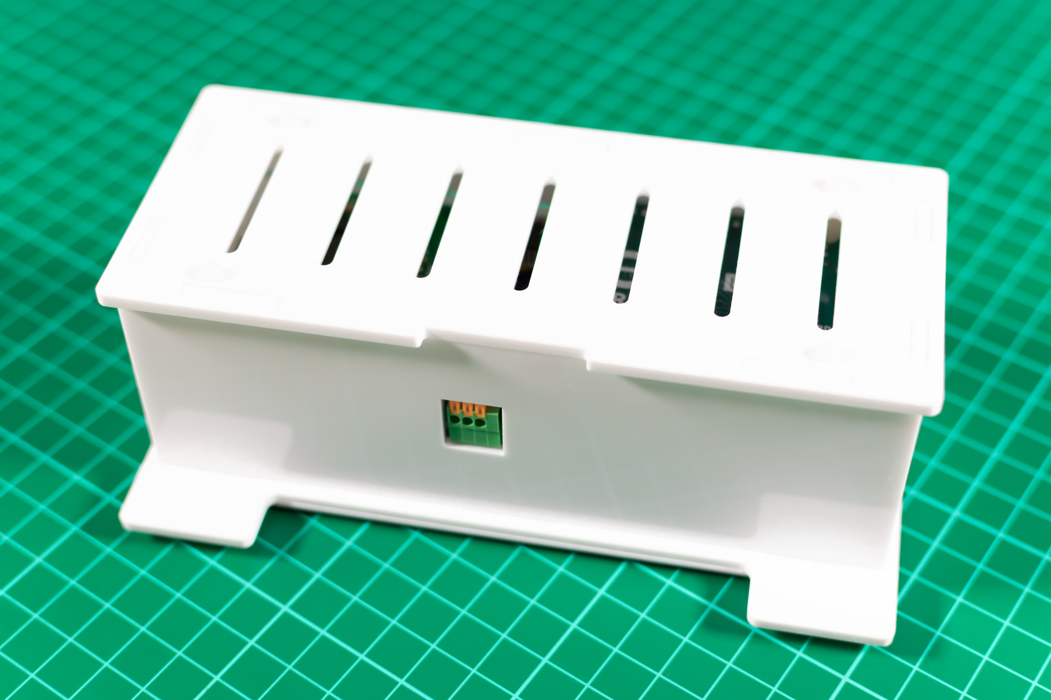
[picture p57: extras/assembly-instruction-images/nixie-shield-assembly-instruction_52.jpg]


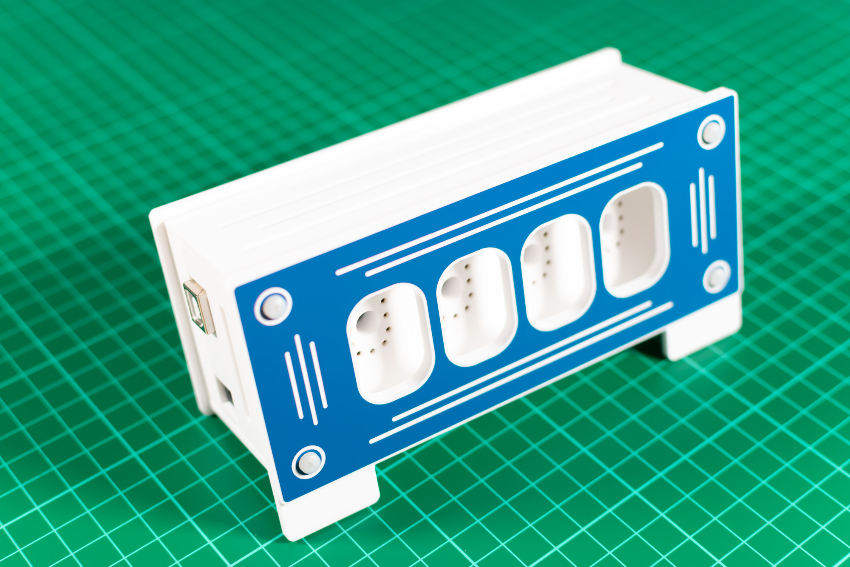
[picture p58: extras/assembly-instruction-images/nixie-shield-assembly-instruction_54.jpg]
