marcinsaj/Nixie-Clock-Thermometer-Hygrometer-Arduino-Shield/(threads)

Thread 1 (2019-08-09):

Power requirements

davidbritch, 2019-08-09:
I get that programming the Arduino requires a USB A to USB B cable. I'm just wondering if it's also possible to power the finished device from a USB cable?

marcinsaj, 2019-08-09:
@davidbritch
You need external power supply 12V 1A. USB connection only for programing.

Closed 2019-08-09.
