marcinsaj/Nixie-Clock-Thermometer-Hygrometer-Arduino-Shield/(commit log)

2019-03-26 Update and rename code to 01-Driving-Nixie-Tubes.ino
2019-07-10 Create 04-Nixie-Clock-12H-24H-Slot-Machine-Effect
2019-08-06 Create assembly-instruction.md
2019-08-06 Create assembly-instruction
2019-12-08 Compute heat index in Celsius
